wadreon-bits/Scope_TargetLock/Notes/V4_SectionMain.JPG

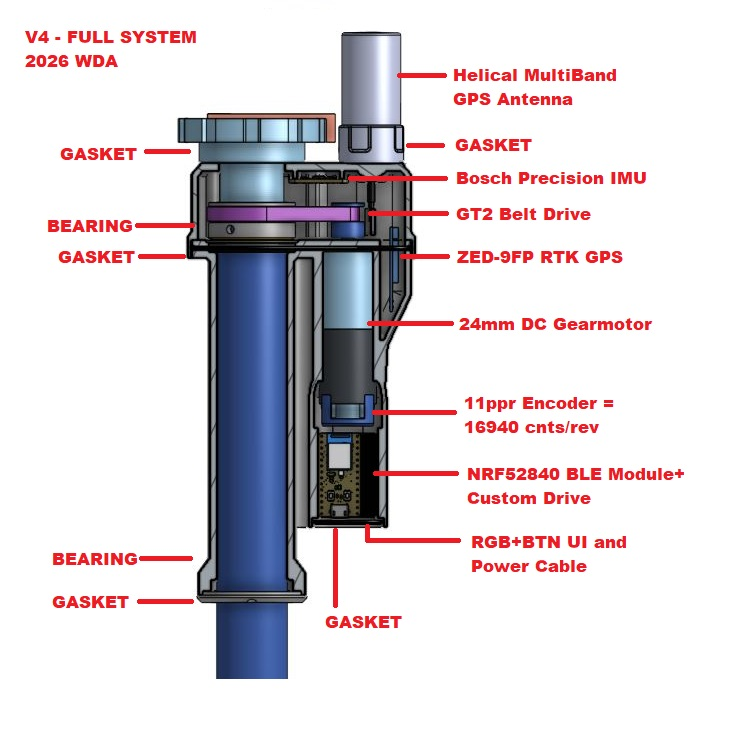
Notes/V4_SectionMain.JPG
