wadreon-bits/Scope_TargetLock/README.md

# Scope_TargetLock
Control system for scope rotation and target locking functionality. 
Released for testing summer 2026. Not a lot of use yet 072126. New boat- new gear.
Pedal V1 and V2 work with all early versions. No changes to packet or ble profile.

V13 rotator is the released version using full target-lock features. Well see how much I ever pick this up again.

It was a blast to build, Just wierd timing right at a new boat when gear is changing every year.

Finished using Claude Code in VScode on the HP Zbook from SMT. 
Started developing V12-V13 in VScode. There is ongoing notes in VS code in the project.
