wadreon-bits/Scope_TargetLock/README_VERSIONS.txt

The first real version used in the Boat-  Rotator V2 with PedalV1. This is a simple rotator app combo with no encoding
PACKAGE_RELEASE0_BASICROTATOR = ROTATOR_V2 + PEDAL_V1
HW = Onshape [Collar_28M_V3] and [Assembly_28V3]		28mm design without encoder. Basic V1 Pedal
NOTES: Pedal_V1 is compatible with rotator code versions through V8a. Soon after V8a, a command framing was added.(This Statement did not hold true- No framing added to pedal or rotator through V9)

PACKAGE_RELEASE1_HEADINGLOCK	= ROTATOR_V8a + PEDAL_V1
HW = Onshape [Collar_24M_V3] and [Assembly_24V3]		24mm design with encoder. Basic V1 Pedal
NOTES:  There was not formal placement of the BNO085 sensor. Just taped on for now. This version was for testing only. 
	HW not finished to provide place for sensor. 

PACKAGE_RELEASE2_TARGETLOCK	= BLE_Rotator_V13 + BLE_Pedal_V2
HW = Onshape [Collar_24M_V4] and [Assembly_TargetHead]		24mm design with encoder.
