wadreon-bits/Scope_TargetLock/Notes/AntennaView1.JPG

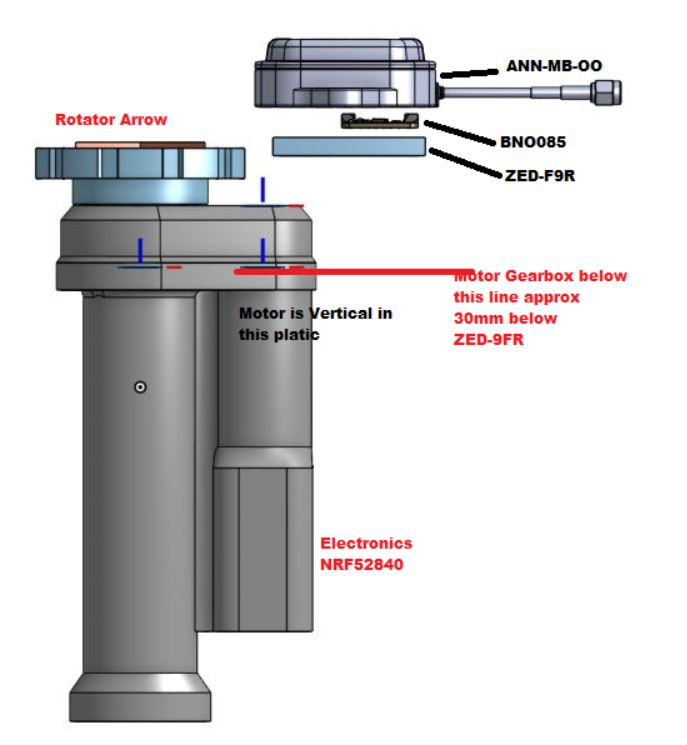
Notes/AntennaView1.JPG
