wadreon-bits/Scope_TargetLock/Notes/AntennaView2.JPG

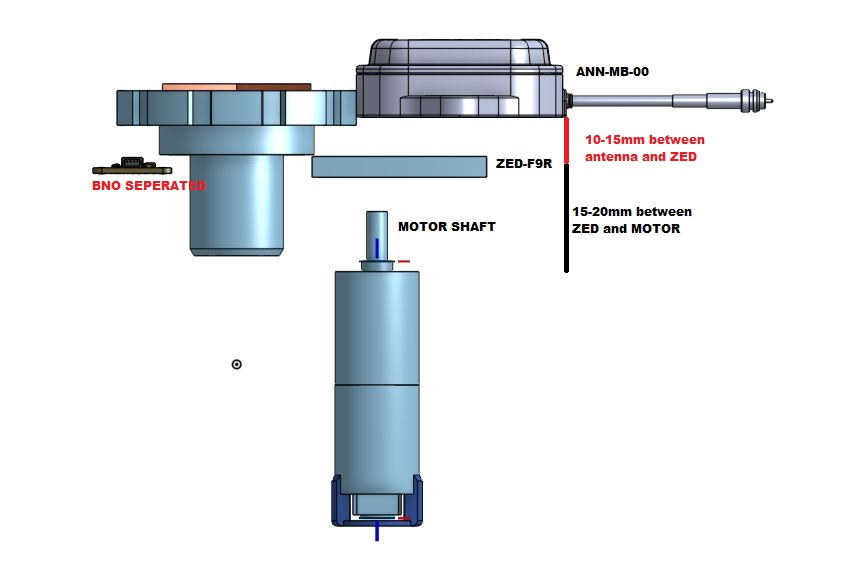
Notes/AntennaView2.JPG
