wadreon-bits/Scope_TargetLock/Notes/V4_FullView.JPG

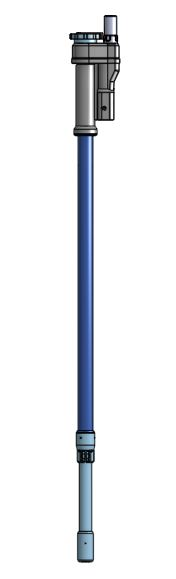
Notes/V4_FullView.JPG
