wadreon-bits/Scope_TargetLock/(commit log)

2026-04-04 First commit- V12B - Just added new vector and needs testing. Not sure how to get a good magnetic NSEW reading.
2026-07-27 Release summer 2026. Boat has an original Basic Rotator 28mm version that will run on a PedalV1, or should on a V2. The new Scope target version is in boat as well. Using V13.1/2 code and Pedal V2. P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
